lloesche/fumesucker/misc/IMG_0530.jpg

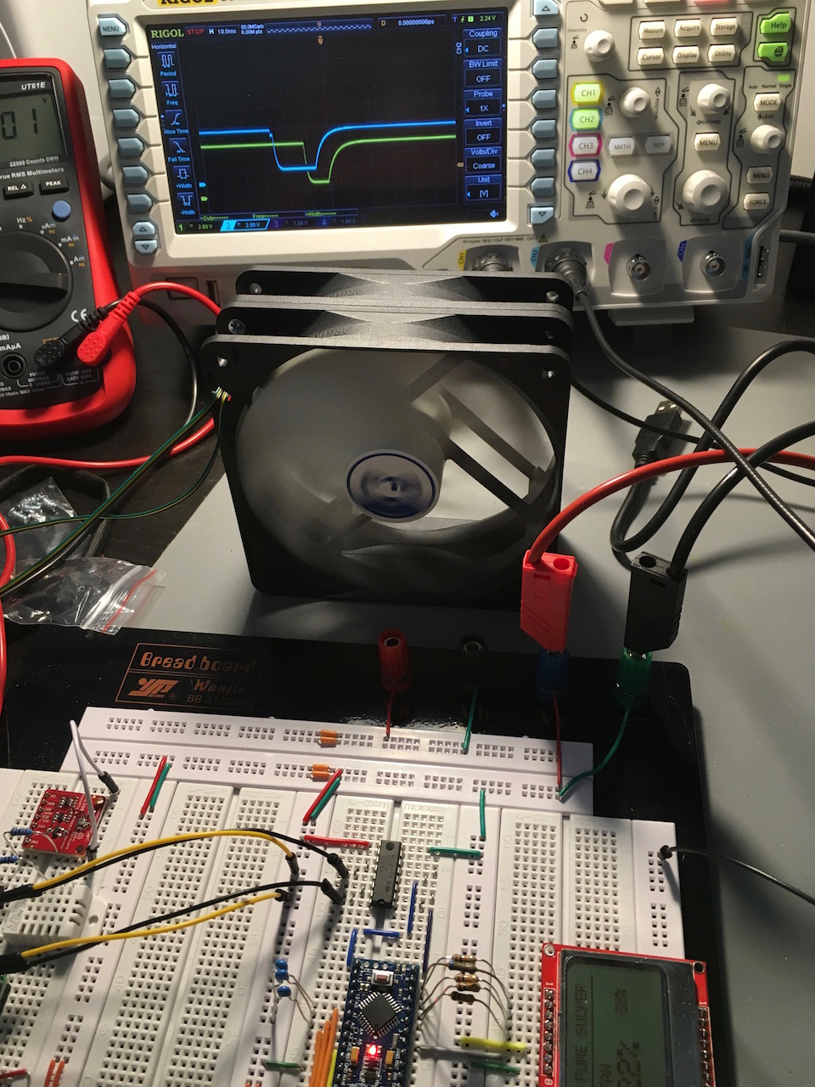
misc/IMG_0530.jpg
