lloesche/fumesucker/misc/IMG_0534.jpg

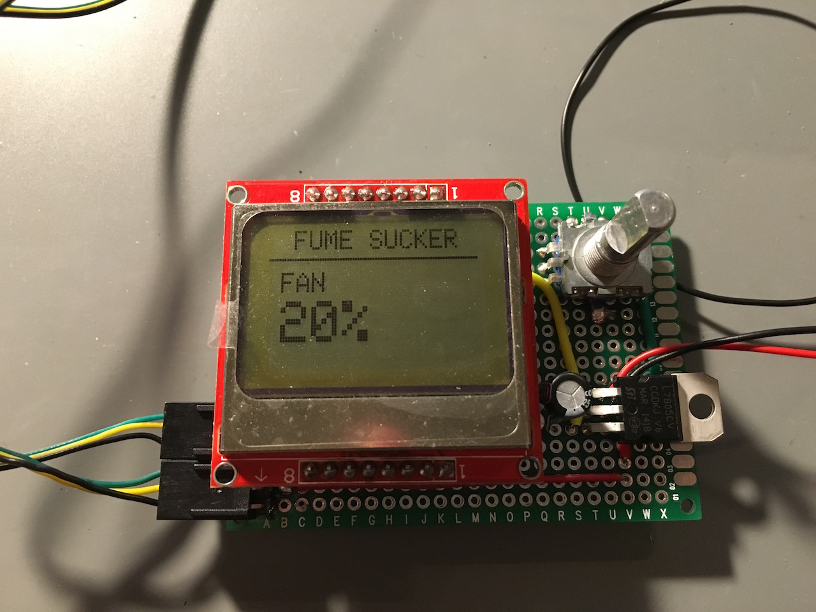
misc/IMG_0534.jpg
